artemisamsx/motherboard-101/README.md

# Artemisa MSX - Model 101 Motherboard 

This repository contains the KiCad project files for the Model 101 motherboard.
