artemisamsx/motherboard-101/motherboard-101.kicad_pcb

## KiCad design motherboard-101.kicad_pcb (2021-08-11)

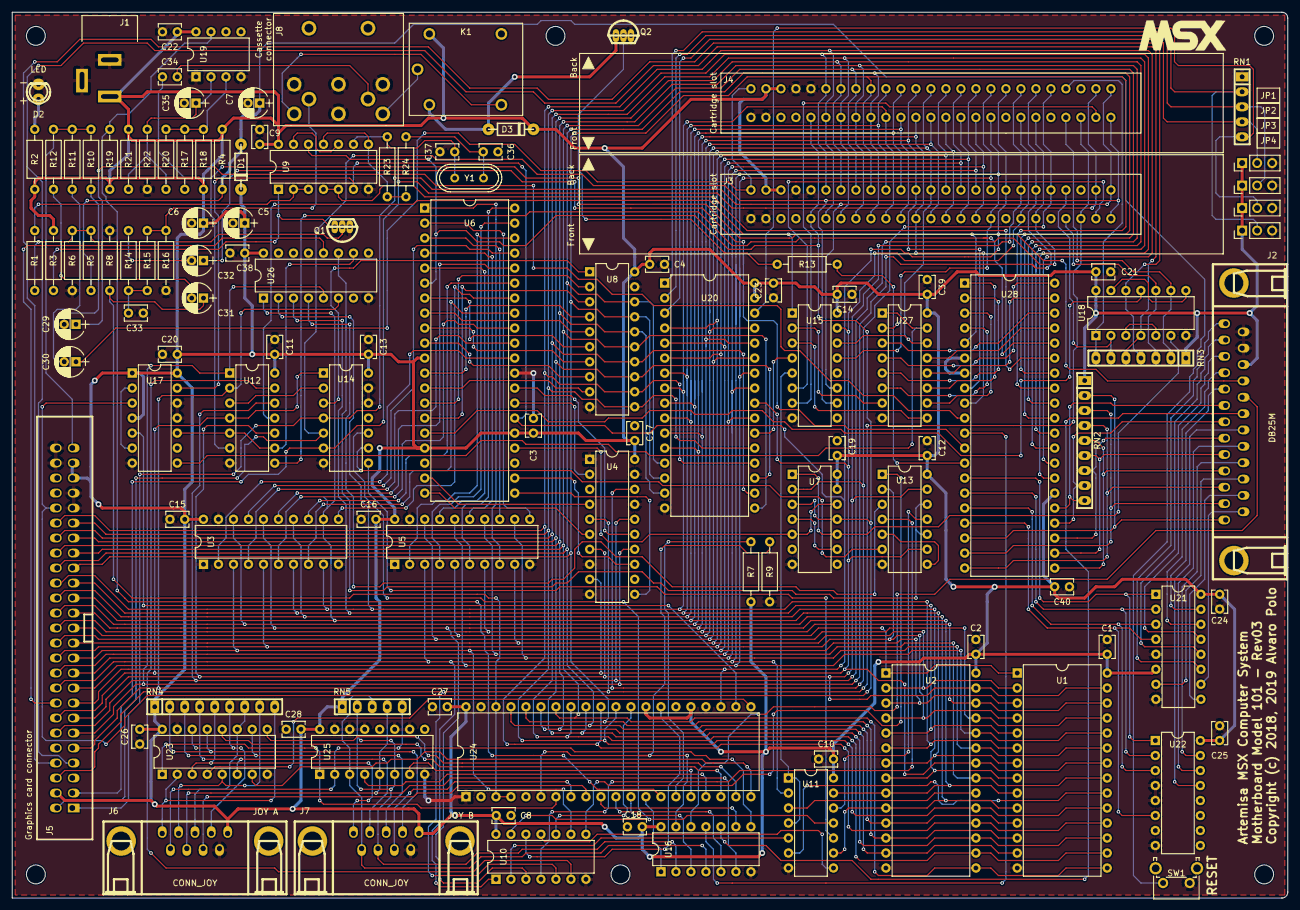
[picture p1: board motherboard-101.kicad_pcb from above]

Board: 2 copper layers, 216.0 x 150.0 mm, 117 parts (0 on the bottom side), 207 nets.

Parts:
C1, C2, C3, C4, C8, C9, C10, C11, C12, C13, C14, C15, C16, C17, C18, C19, C20, C21, C22, C23, C24, C25, C26, C27, C28, C38, C39, C40: 100nF; Disc_capacitor
C5, C7: 100uF; Radial_capacitor
C6: 10uF; Radial_capacitor
C29, C30, C31: 10u; Radial_capacitor
C32, C35: 1uF; Radial_capacitor
C33, C34: 22nF; Disc_capacitor
C36, C37: 33pF; Disc_capacitor
D1, D3: 1N4448; Axial_diode
D2: LED
J1: PWR_conn; Jack_55_21
J2: DB25M
J3, J4: MSX_Slot; Slot_conn
J5: GFX_Connector_Output; GFX_conn
J6, J7: CONN_JOY; Joystick_conn
J8: DIN8
JP1, JP2, JP3, JP4: Jumper
K1: Relay
Q1: 2N2222; TO92
Q2: 2N2907; TO92
R1: 100K; Axial_resistor
R2: 220; Axial_resistor
R3, R6: 4K7; Axial_resistor
R4, R7, R9: 10K; Axial_resistor
R5, R24: 1K; Axial_resistor
R8: 470; Axial_resistor
R10: 20k; Axial_resistor
R11, R14, R15, R17: 4k7; Axial_resistor
R12, R21, R22: 2k7; Axial_resistor
R13: 2k2; Axial_resistor
R16: 100; Axial_resistor
R18: 220k; Axial_resistor
R19: 1k; Axial_resistor
R20: 10k; Axial_resistor
R23: 1M; Axial_resistor
RN1, RN5: 10K; RN4
RN2, RN4: 10K; RN8
RN3: 10K; RN6
SW1: Push_button; Push_button_angled
U1, U2: 62256; DIP-28_600
U3, U4, U5: 74HCT244; DIP-20_300
U6: Z84C00; DIP-40_600
U7, U17: 74HC74; DIP-14_300
U8: 74HCT245; DIP-20_300
U9: 74HCU04; DIP-14_300
U10: 74HC04; DIP-14_300
U11, U12, U13: 74HC32; DIP-14_300
U14: 74HC08; DIP-14_300
U15: 74HC139; DIP-16_300
U16: 74LS07; DIP-14_300
U18: 74HCT08; DIP-14_300
U19: LM311; DIP-8_300
U20: SST39SF0; DIP-32_600
U21, U22, U26: 74HC138; DIP-16_300
U23, U25: 74HC157; DIP-16_300
U24: AY-3-8910; DIP-40_600
U27: 74HC153; DIP-16_300
U28: 82C55A; DIP-40_600
Y1: 3.58Mhz; Crystal

Connections:
/ADDR0: J3.28, J4.28, J5.28, U1.10, U2.10, U3.18, U11.9, U20.12, U28.9
/ADDR1: J3.27, J4.27, J5.27, U1.9, U2.9, U3.16, U10.3, U11.13, U20.11, U28.8
/ADDR14: J3.25, J4.25, J5.25, U1.1, U2.1, U5.5, U15.14, U20.29, U27.14
/ADDR15: J3.18, J4.18, J5.18, U5.3, U10.1, U11.2, U15.13, U27.2
/AUDIO: J5.49, R10.2, R11.2, R12.2
/BEEP: C29.1, U28.10
/CASIN: R19.1, U19.7, U24.14
/CASOUT: C32.1, U28.12
/CLK: J3.42, J4.42, J5.42, U6.6, U7.3, U7.11, U9.12, U17.3
/CPU/A0: U3.2, U6.30
/CPU/A1: U3.4, U6.31
/CPU/A2: U3.6, U6.32
/CPU/A3: U3.8, U6.33
/CPU/A4: U3.11, U6.34
/CPU/A5: U3.13, U6.35
/CPU/A6: U3.15, U6.36
/CPU/A7: U3.17, U6.37
/CPU/A8: U5.2, U6.38
/CPU/A9: U5.4, U6.39
/CPU/A10: U5.6, U6.40
/CPU/A11: U5.8, U6.1
/CPU/A12: U5.11, U6.2
/CPU/A13: U5.13, U6.3
/CPU/A14: U5.15, U6.4
/CPU/A15: U5.17, U6.5
/CPU/ADDR2: J3.30, J4.30, J5.30, U1.8, U2.8, U3.14, U20.10
/CPU/ADDR3: J3.29, J4.29, J5.29, U1.7, U2.7, U3.12, U20.9, U26.1
/CPU/ADDR4: J3.32, J4.32, J5.32, U1.6, U2.6, U3.9, U20.8, U26.2
/CPU/ADDR5: J3.31, J4.31, J5.31, U1.5, U2.5, U3.7, U20.7, U26.3
/CPU/ADDR6: J3.22, J4.22, J5.22, U1.4, U2.4, U3.5, U13.2, U20.6
/CPU/ADDR7: J3.21, J4.21, J5.21, U1.3, U2.3, U3.3, U10.9, U20.5
/CPU/ADDR8: J3.24, J4.24, J5.24, U1.25, U2.25, U5.18, U20.27
/CPU/ADDR9: J3.17, J4.17, J5.17, U1.24, U2.24, U5.16, U20.26
/CPU/ADDR10: J3.20, J4.20, J5.20, U1.21, U2.21, U5.14, U20.23
/CPU/ADDR11: J3.19, J4.19, J5.19, U1.23, U2.23, U5.12, U20.25
/CPU/ADDR12: J3.23, J4.23, J5.23, U1.2, U2.2, U5.9, U20.4
/CPU/ADDR13: J3.26, J4.26, J5.26, U1.26, U2.26, U5.7, U20.28
/CPU/D0: U6.14, U8.2
/CPU/D1: U6.15, U8.3
/CPU/D2: U6.12, U8.4
/CPU/D3: U6.8, U8.5
/CPU/D4: U6.7, U8.6
/CPU/D5: U6.9, U8.7
/CPU/D6: U6.10, U8.8
/CPU/D7: U6.13, U8.9
/CPU/DATA0: J3.34, J4.34, J5.34, U1.11, U2.11, U8.18, U20.13, U24.37, U28.34
/CPU/DATA1: J3.33, J4.33, J5.33, U1.12, U2.12, U8.17, U20.14, U24.36, U28.33
/CPU/DATA2: J3.36, J4.36, J5.36, U1.13, U2.13, U8.16, U20.15, U24.35, U28.32
/CPU/DATA3: J3.35, J4.35, J5.35, U1.15, U2.15, U8.15, U20.17, U24.34, U28.31
/CPU/DATA4: J3.38, J4.38, J5.38, U1.16, U2.16, U8.14, U20.18, U24.33, U28.30
/CPU/DATA5: J3.37, J4.37, J5.37, U1.17, U2.17, U8.13, U20.19, U24.32, U28.29
/CPU/DATA6: J3.40, J4.40, J5.40, U1.18, U2.18, U8.12, U20.20, U24.31, U28.28
/CPU/DATA7: J3.39, J4.39, J5.39, U1.19, U2.19, U8.11, U20.21, U24.30, U28.27
/DATADIR: U8.1, U14.3
/DECODING/~PPISL: U12.5, U12.9, U17.10, U26.10
/DECODING/~PSGBDIR: U10.13, U11.11, U14.10
/DECODING/~PSGRD: U13.5, U13.8
/DECODING/~PSGSL: U13.10, U13.12, U26.11
/DECODING/~PSGWR: U11.12, U13.11
/EXTSOUND: C30.1, J3.49, J4.49
/KBD/KBCOL0: J2.1, RN2.2, U28.18
/KBD/KBCOL1: J2.2, RN2.3, U28.19
/KBD/KBCOL2: J2.3, RN2.4, U28.20
/KBD/KBCOL3: J2.4, RN2.5, U28.21
/KBD/KBCOL4: J2.5, RN2.6, U28.22
/KBD/KBCOL5: J2.6, RN2.7, U28.23
/KBD/KBCOL6: J2.7, RN2.8, U28.24
/KBD/KBCOL7: J2.8, RN2.9, U28.25
/KBD/KBROW0: U21.1, U22.1, U28.14
/KBD/KBROW1: U21.2, U22.2, U28.15
/KBD/KBROW2: U21.3, U22.3, U28.16
/KBD/KBROW3: U21.4, U22.6, U28.17
/KBD/~CAPSL: J2.20, U16.10
/KBD/~KANAL: J2.21, U16.12
/KBD/~RSL0: J2.9, U21.15
/KBD/~RSL1: J2.10, U21.14
/KBD/~RSL2: J2.11, U21.13
/KBD/~RSL3: J2.12, U21.12
/KBD/~RSL4: J2.13, U21.11
/KBD/~RSL5: J2.14, U21.10
/KBD/~RSL6: J2.15, U21.9
/KBD/~RSL7: J2.16, U21.7
/KBD/~RSL8: J2.17, U22.15
/KBD/~RSL9: J2.18, U22.14
/KBD/~RSL10: J2.19, U22.13
/PPI/PA0: U27.6, U28.4
/PPI/PA1: U27.10, U28.3
/PPI/PA2: U27.5, U28.2
/PPI/PA3: U27.11, U28.1
/PPI/PA4: U27.4, U28.40
/PPI/PA5: U27.12, U28.39
/PPI/PA6: U27.3, U28.38
/PPI/PA7: U27.13, U28.37
/PSG/IOA0: U23.4, U24.21
/PSG/IOA1: U23.7, U24.20
/PSG/IOA2: U23.9, U24.19
/PSG/IOA3: U23.12, U24.18
/PSG/IOA4: U24.17, U25.4
/PSG/IOA5: U24.16, U25.7
/PSG/IOB0: U16.1, U24.13
/PSG/IOB1: U16.3, U24.12
/PSG/IOB2: U16.5, U24.11
/PSG/IOB3: U16.9, U24.10
/PSG/IOB4: J6.8, U24.9
/PSG/IOB5: J7.8, U24.8
/PSG/IOB6: U23.1, U24.7, U25.1
/PSG/JOYA1: J6.1, RN4.9, U23.2
/PSG/JOYA2: J6.2, RN4.8, U23.5
/PSG/JOYA3: J6.3, RN4.7, U23.11
/PSG/JOYA4: J6.4, RN4.6, U23.14
/PSG/JOYA6: J6.6, RN5.5, U16.8, U25.2
/PSG/JOYA7: J6.7, RN5.4, U16.6, U25.5
/PSG/JOYB1: J7.1, RN4.5, U23.3
/PSG/JOYB2: J7.2, RN4.4, U23.6
/PSG/JOYB3: J7.3, RN4.3, U23.10
/PSG/JOYB4: J7.4, RN4.2, U23.13
/PSG/JOYB6: J7.6, RN5.3, U16.4, U25.3
/PSG/JOYB7: J7.7, RN5.2, U16.2, U25.6
/PSGBC1: U10.10, U24.29
/PSGBDIR: U10.12, U24.27
/PSGCLK: U17.5, U24.22
/RESET: U9.4, U9.5, U28.35
/SLOTS/~EXTINT2: J3.8, RN3.3, U18.10
/SLOTS/~EXTINT3: J4.8, RN3.2, U18.9
/SLOTS/~EXTWAIT2: J3.7, RN3.6, U18.2
/SLOTS/~EXTWAIT3: J4.7, RN3.7, U18.1
/SLOTS/~VDPINT: J5.8, RN3.4, U18.12
/SLOTS/~VDPWAIT: J5.7, RN3.5, U18.4
/~CAPSLOCK: U16.11, U28.11
/~CASMOTOR: R13.2, U28.13
/~CS1: J3.1, J4.1, J5.1, U14.4, U15.11
/~CS2: J3.2, J4.2, J5.2, U14.5, U15.10
/~CS12: J3.3, J4.3, J5.3, U14.6
/~EXTINT: U6.16, U18.11
/~EXTWAIT: U7.1, U7.10, U18.6
/~IORQ: J3.11, J4.11, J5.11, U4.14, U12.1, U26.5
/~KANALOCK: R9.1, U16.13, U24.6
/~M1: J3.9, J4.9, J5.9, U4.18, U7.2, U12.2, U26.6
/~MREQ: J3.12, J4.12, J5.12, U4.16, U12.12
/~PPIRD: U12.6, U28.5
/~PPIRDY: U17.8, U27.1, U27.15
/~PPIWR: U12.8, U28.36
/~RAMSL0: U1.20, U11.6
/~RAMSL1: U2.20, U11.3
/~RD: J3.14, J4.14, J5.14, U1.22, U2.22, U4.9, U12.4, U13.9, U14.1, U15.15, U20.24
/~RESET: J2.22, J3.15, J4.15, J5.15, U6.26, U9.6, U17.13, U24.23
/~RFSH: J3.6, J4.6, J5.6, U4.5, U10.5
/~SLTSL0: U15.4, U20.22
/~SLTSL1: U11.1, U11.4, U15.5
/~SLTSL2: J3.4, U15.6
/~SLTSL3: J4.4, U15.7
/~SLTSLEN: U12.11, U15.1
/~VDPSL: J5.16, U26.12
/~WR: J3.13, J4.13, J5.13, U1.27, U2.27, U4.7, U12.10, U13.13
GND: C1.2, C2.2, C3.2, C4.2, C5.2, C6.2, C7.2, C8.2, C9.2, C10.2, C11.2, C12.2, C13.2, C14.2, C15.2, C16.2, C17.2, C18.2, C19.2, C20.2, C21.2, C22.2, C23.2, C24.2, C25.2, C26.2, C27.2, C28.2, C33.2, C35.2, C36.2, C37.2, C38.2, C39.2, C40.2, D2.2, J1.2, J1.3, J2.24, J2.25, J3.41, J3.43, J3.48, J3.50, J4.41, J4.43, J4.48, J4.50, J5.41, J5.43, J5.48, J5.50, J6.9, J7.9, J8.1, J8.2, J8.3, J8.8, JP1.3, JP2.3, JP3.3, JP4.3, Q1.3, Q2.1, R6.2, R8.2, R9.2, R16.1, R22.1, RN1.1, SW1.1, U1.14, U2.14, U3.1, U3.10, U3.19, U4.1, U4.8, U4.10, U4.17, U4.19, U5.1, U5.10, U5.19, U6.29, U7.7, U8.10, U8.19, U9.7, U10.7, U11.7, U12.7, U13.7, U14.7, U14.12, U14.13, U15.8, U16.7, U17.7, U17.11, U17.12, U18.7, U19.1, U19.4, U20.16, U21.5, U21.8, U22.4, U22.5, U22.8, U23.8, U23.15, U24.1, U24.24, U25.8, U25.10, U25.11, U25.13, U25.14, U25.15, U26.8, U27.8, U28.6, U28.7
unnamed: C7.1, D1.1, R4.2, R5.2, SW1.2
unnamed: C29.2, R10.1
unnamed: C30.2, R11.1
unnamed: C31.1, R8.1, U24.3, U24.4, U24.38
unnamed: C31.2, R12.1
unnamed: C32.2, R14.2
unnamed: C33.1, R14.1, R15.2
unnamed: C34.1, R17.1
unnamed: C34.2, J8.5
unnamed: C35.1, R20.2, R21.1, R22.2, U19.2
unnamed: C36.1, R23.1, U9.9, Y1.1
unnamed: C37.1, R24.1, Y1.2
unnamed: D2.1, R2.2
unnamed: D3.1, K1.2, Q2.3
unnamed: J8.4, R15.1, R16.2
unnamed: J8.6, K1.4
unnamed: J8.7, K1.3
unnamed: JP1.2, RN1.4, U20.3
unnamed: JP2.2, RN1.3, U20.2
unnamed: JP3.2, RN1.5, U20.30
unnamed: JP4.2, RN1.2, U20.1
unnamed: Q1.1, R3.2, U9.1
unnamed: Q1.2, R1.2, R5.1, R6.1
unnamed: Q2.2, R13.1
unnamed: R1.1, U9.2, U9.3
unnamed: R7.2, U24.15
unnamed: R17.2, R18.1, R20.1, U19.3
unnamed: R23.2, R24.2, U9.8, U9.11
unnamed: U4.2, U6.27
unnamed: U4.4, U6.19
unnamed: U4.6, U6.20
unnamed: U4.11, U6.21
unnamed: U4.13, U6.22
unnamed: U4.15, U6.28
unnamed: U6.24, U7.5, U7.12
unnamed: U7.4, U7.9
unnamed: U9.10, U9.13
unnamed: U10.2, U11.5
unnamed: U10.4, U13.4
unnamed: U10.6, U12.13
unnamed: U10.8, U13.1
unnamed: U10.11, U11.8
unnamed: U11.10, U14.8
unnamed: U12.3, U14.2
unnamed: U13.3, U26.4
unnamed: U13.6, U14.9
unnamed: U15.2, U27.7
unnamed: U15.3, U27.9
unnamed: U17.2, U17.6
unnamed: U18.3, U18.5
unnamed: U18.8, U18.13
~: C1.1, C2.1, C3.1, C4.1, C5.1, C6.1, C8.1, C9.1, C10.1, C11.1, C12.1, C13.1, C14.1, C15.1, C16.1, C17.1, C18.1, C19.1, C20.1, C21.1, C22.1, C23.1, C24.1, C25.1, C26.1, C27.1, C28.1, C38.1, C39.1, C40.1, D1.2, D3.2, J1.1, J2.23, J3.45, J3.47, J4.45, J4.47, J5.4, J5.45, J5.47, J6.5, J7.5, JP1.1, JP2.1, JP3.1, JP4.1, K1.1, R2.1, R3.1, R4.1, R7.1, R18.2, R19.2, R21.2, RN2.1, RN3.1, RN4.1, RN5.1, U1.28, U2.28, U3.20, U4.20, U5.20, U6.11, U6.17, U6.25, U7.13, U7.14, U8.20, U9.14, U10.14, U11.14, U12.14, U13.14, U14.14, U15.16, U16.14, U17.1, U17.4, U17.14, U18.14, U19.8, U20.31, U20.32, U21.6, U21.16, U22.16, U23.16, U24.25, U24.28, U24.40, U25.16, U26.16, U27.16, U28.26
