artemisamsx/motherboard-101/CHANGELOG.md

# Artemisa Motherboard Mk.I Changelog

## Rev 3

- Replace 74HCT11 by 74HCT32
- Replace 74HC154 by a pair of 74HC138
- Fix via sizes to conform JLCPCB design rules
- Make the right PCB corners rounded

## Rev 2

- Replace power-on reset circuit to make it work
- Fix wrong orientation of slot connectors
- Fix wrong placement of keyboard and joystick connectors
- Move slot connectors to make room to the case screws
- VCC power traces improved

## Rev 1

First revision of the board
