artemisamsx/motherboard-101/(commit log)

2020-05-17 Rename motherboard project to model 101
    [cassette.sch, clk.sch, clock.sch, cpu.sch, decoding.sch, io.sch, keyboard.sch, motherboard-101.kicad_pcb]
2021-03-23 Use kicadlibs as submodule
    [motherboard-101.kicad_pcb]
2021-04-12 Fix wrong location of relay 3D model
    [motherboard-101.kicad_pcb]
2021-04-13 Update plot properties
    [cassette.sch, clock.sch, cpu.sch, decoding.sch, keyboard.sch, motherboard-101.sch, power.sch, ppi.sch]
2021-04-13 Move decoupling capacitors out from power sheet
    Put them where the first part of the IC is used.
    [cassette.sch, clock.sch, cpu.sch, decoding.sch, keyboard.sch, motherboard-101.kicad_pcb, power.sch, slots.sch]
2021-04-14 Update 7404 parts to have the power pins in the first unit
    [decoding.sch, power.sch]
2021-04-15 Update 7408 parts to have the power pins in the first unit
    [decoding.sch, motherboard-101.kicad_pcb, slots.sch]
2021-04-15 Update 74139 parts to have the power pins in the first unit
    [decoding.sch, motherboard-101.kicad_pcb, ppi.sch]
2021-08-11 Unknown changes to power.sch
    [power.sch]
2021-08-11 Update 7474 parts to have the power pins in the first unit
    [clock.sch, cpu.sch, motherboard-101.kicad_pcb, ppi.sch]
2022-04-28 Upgrade project files to KiCad 6
    [cassette.kicad_sch, cassette.sch, clk.sch, clock.kicad_sch, clock.sch, cpu.kicad_sch, cpu.sch, decoding.kicad_sch]
2024-01-18 Fix wrong cap type in clock generator
    Also fill some references automatically generated by KiCAD.
    [cassette.kicad_sch, clock.kicad_sch, cpu.kicad_sch, decoding.kicad_sch, keyboard.kicad_sch, power.kicad_sch, ppi.kicad_sch, psg.kicad_sch]
2024-08-26 Upgrade project files to KiCad v8
    [cassette.kicad_sch, clock.kicad_sch, cpu.kicad_sch, decoding.kicad_sch, keyboard.kicad_sch, motherboard-101.kicad_sch, power.kicad_sch, ppi.kicad_sch]
