artemisamsx/motherboard-101/(notices)

Notices in the files:
motherboard-101.kicad_pcb:
Copyright (c) 2018, 2019 Alvaro Polo
